CKalitin/analog-bms/README.md

# analog-bms
1s2p Li-ion battery module with an analog battery management system (BMS).

### [**Read The Project Blog Post!!**](https://ckalitin.github.io/analogbms/)



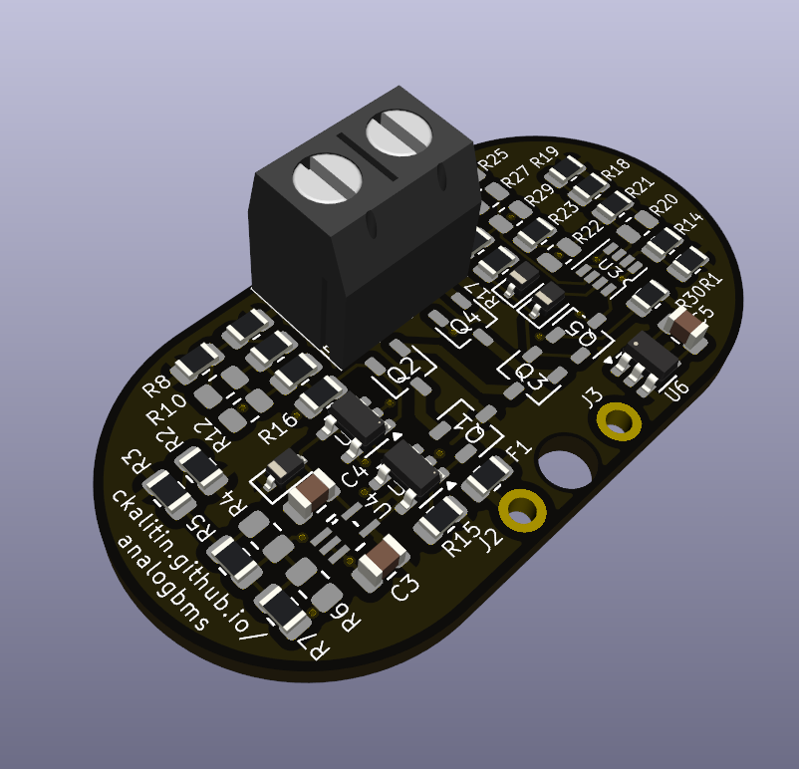
[picture p1: renders/PCB_kicad_3d.png]


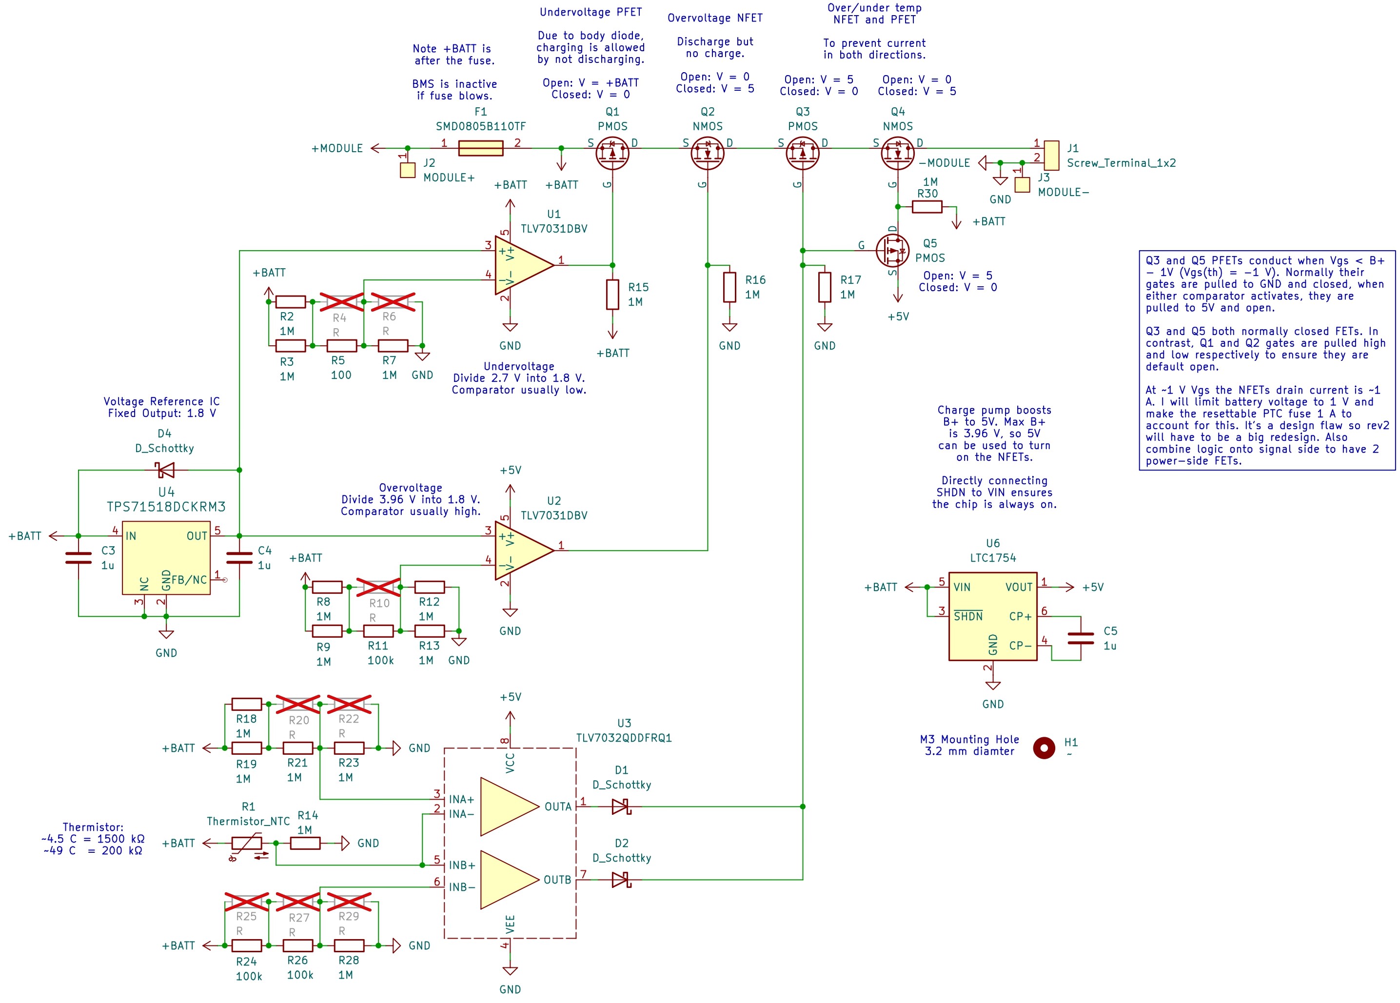
[picture p2: renders/PCB_schematic.jpg]


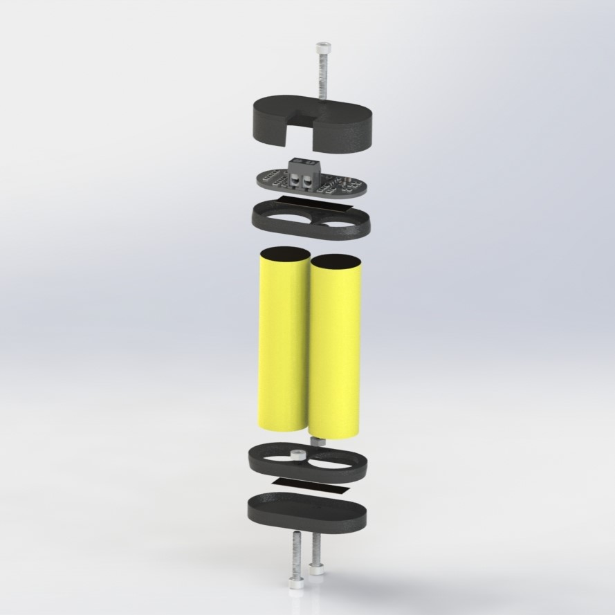
[picture p3: renders/module_exploded.JPG]


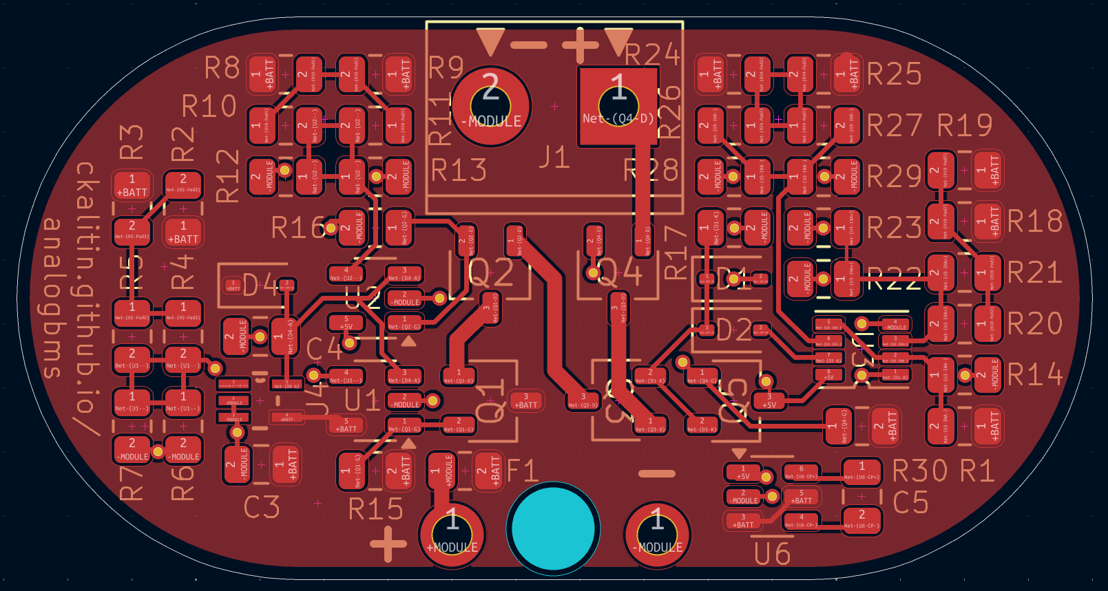
[picture p4: renders/PCB_kicad_top_layer.png]
