CKalitin/analog-bms/pcb/analog_bms_rev1/Images/doro.jpg

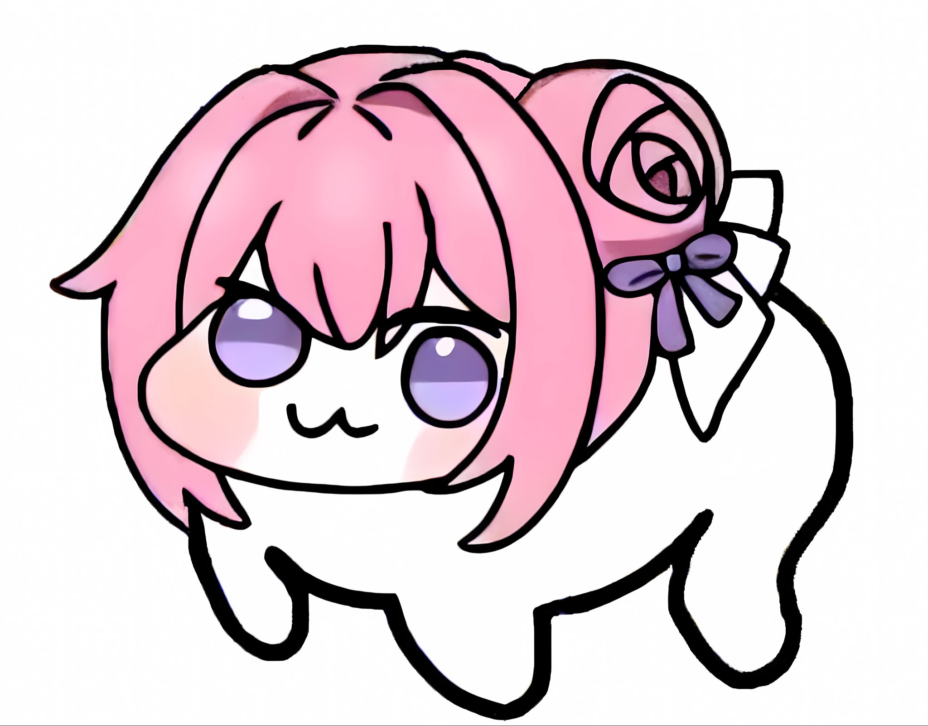
pcb/analog_bms_rev1/Images/doro.jpg
