CKalitin/analog-bms/pcb/analog_bms_rev1/Images/happy-pepe.png

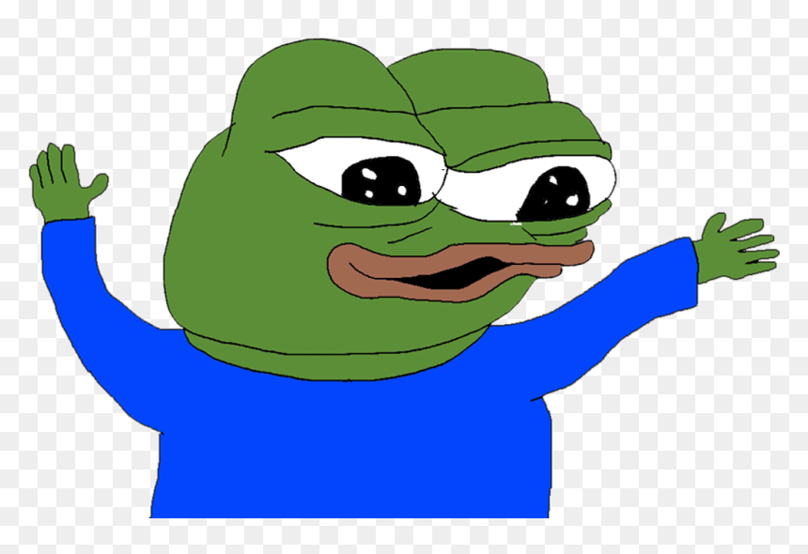
pcb/analog_bms_rev1/Images/happy-pepe.png
