CKalitin/analog-bms/pcb/analog_bms_rev1/Images/pepe-grill.png

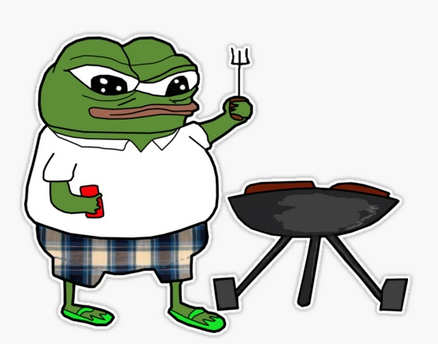
pcb/analog_bms_rev1/Images/pepe-grill.png
