CKalitin/analog-bms/pcb/analog_bms_rev1/Images/pepe-sophisticated.png

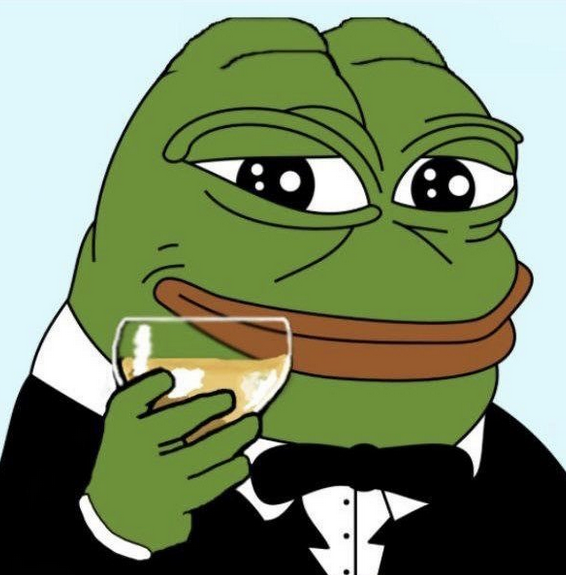
pcb/analog_bms_rev1/Images/pepe-sophisticated.png
