CKalitin/analog-bms/pcb/analog_bms_rev1/Images/pepe-surprised.png

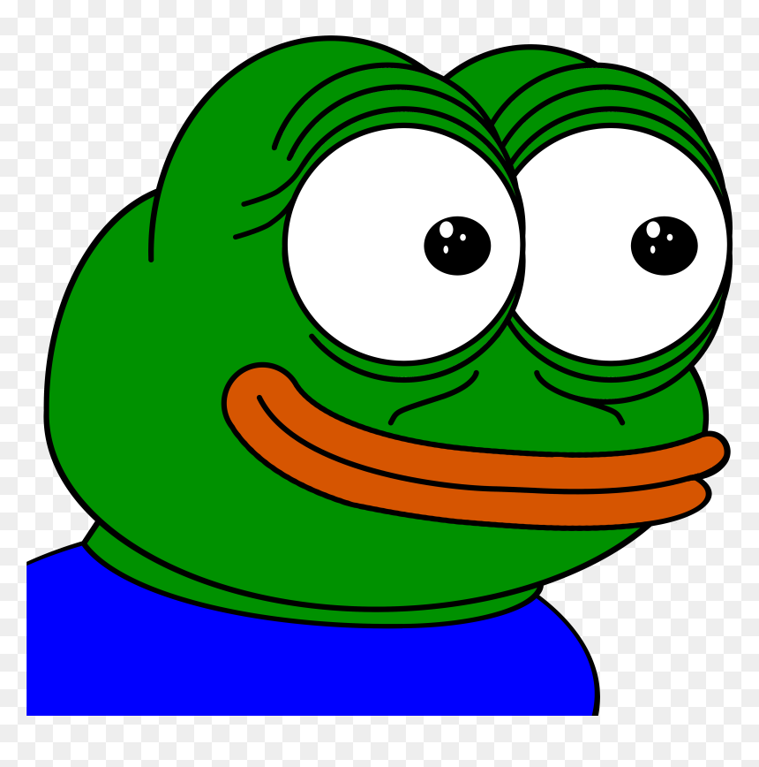
pcb/analog_bms_rev1/Images/pepe-surprised.png
