CKalitin/analog-bms/pcb/analog_bms_rev1/Images/soyface-wow.png

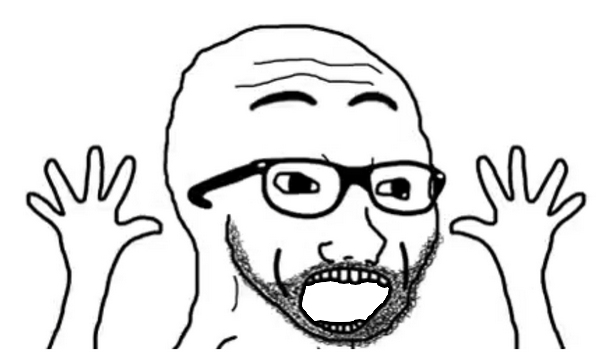
pcb/analog_bms_rev1/Images/soyface-wow.png
