CKalitin/analog-bms/renders/rev1/module.JPG

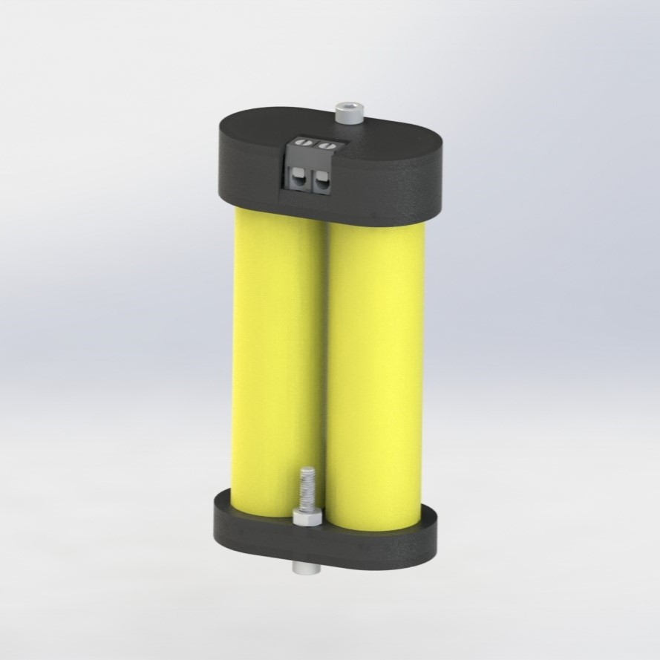
renders/rev1/module.JPG
