CKalitin/analog-bms/renders/rev1/PCB_kicad_top_down.png

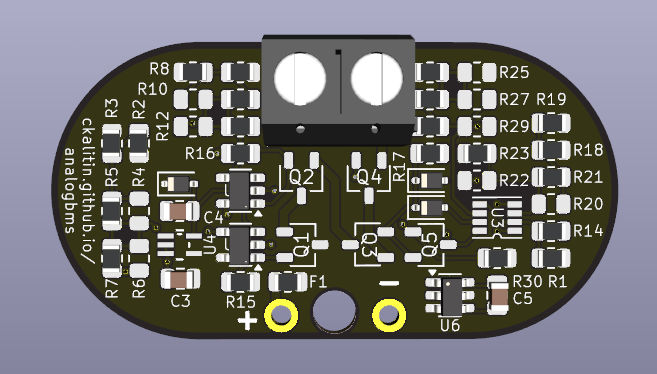
renders/rev1/PCB_kicad_top_down.png
