CKalitin/analog-bms/pcb/analog_bms_rev1/analog_bms.step

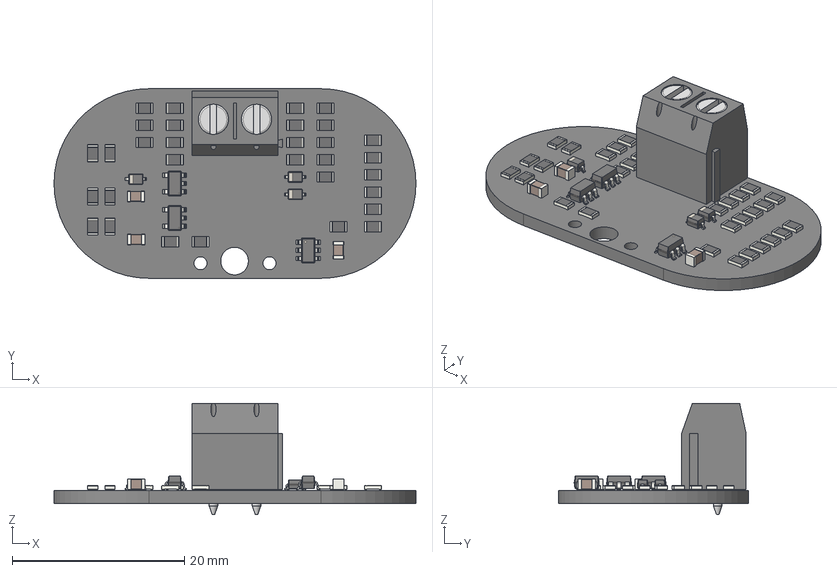
[picture p13: CAD file, 2025-08-20]
pcb/analog_bms_rev1/analog_bms.step
42.0 x 22.0 x 12.9 mm
R_0805_2012Metric x 31
D_SOD-323 x 3
SOT-23-5 x 2
C_0805_2012Metric x 3
SOT-23-6
6915027100xx_CAGE x 2
6915027100xx_PIN x 2
6915027100xx_VIS x 2
analog_bms_PCB
