CKalitin/analog-bms/cad/rev1/Top_Battery_Holder_Plate.SLDPRT

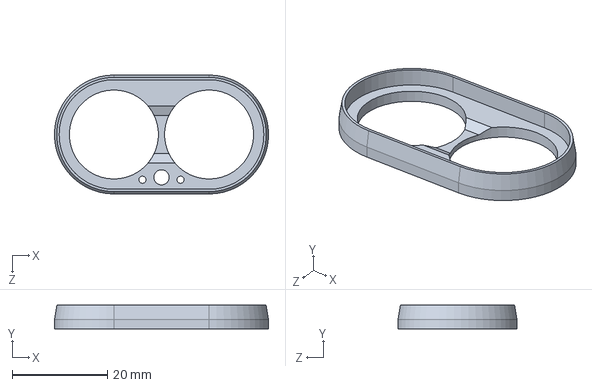
[picture p14: CAD file, 2025-08-20]
cad/rev1/Top_Battery_Holder_Plate.SLDPRT
45.0 x 5.00 x 25.0 mm
