CKalitin/analog-bms/cad/rev1/Top_Module_Exterior_Plate.SLDPRT

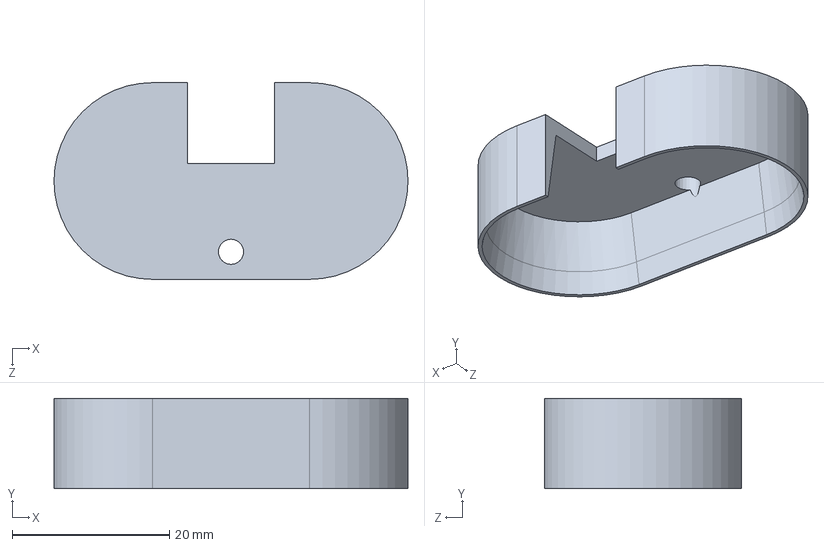
[picture p15: CAD file, 2025-08-20]
cad/rev1/Top_Module_Exterior_Plate.SLDPRT
45.0 x 11.5 x 25.0 mm
