CKalitin/analog-bms/cad/rev1/Bottom_Module_Exterior_Plate.SLDPRT

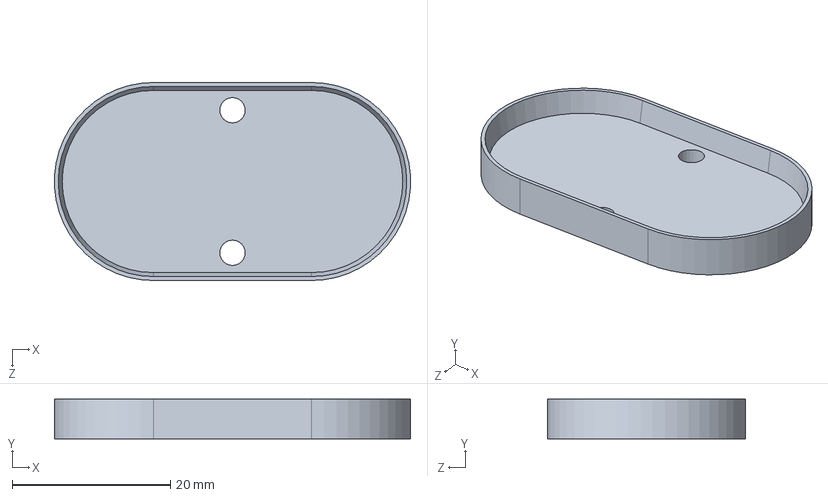
[picture p16: CAD file, 2025-08-20]
cad/rev1/Bottom_Module_Exterior_Plate.SLDPRT
45.0 x 5.00 x 25.0 mm
