CKalitin/analog-bms/cad/rev1/PCB-Printable.SLDPRT

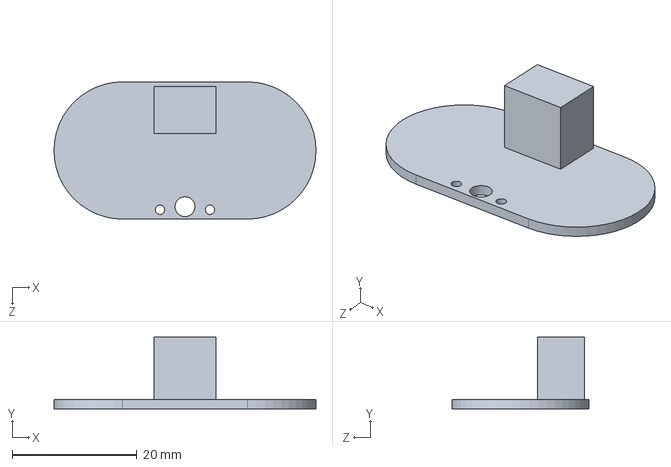
[picture p17: CAD file, 2025-08-20]
cad/rev1/PCB-Printable.SLDPRT
42.0 x 11.5 x 22.0 mm
