CKalitin/analog-bms/pcb/analog_bms_rev1/3D Models/691502710002.stp

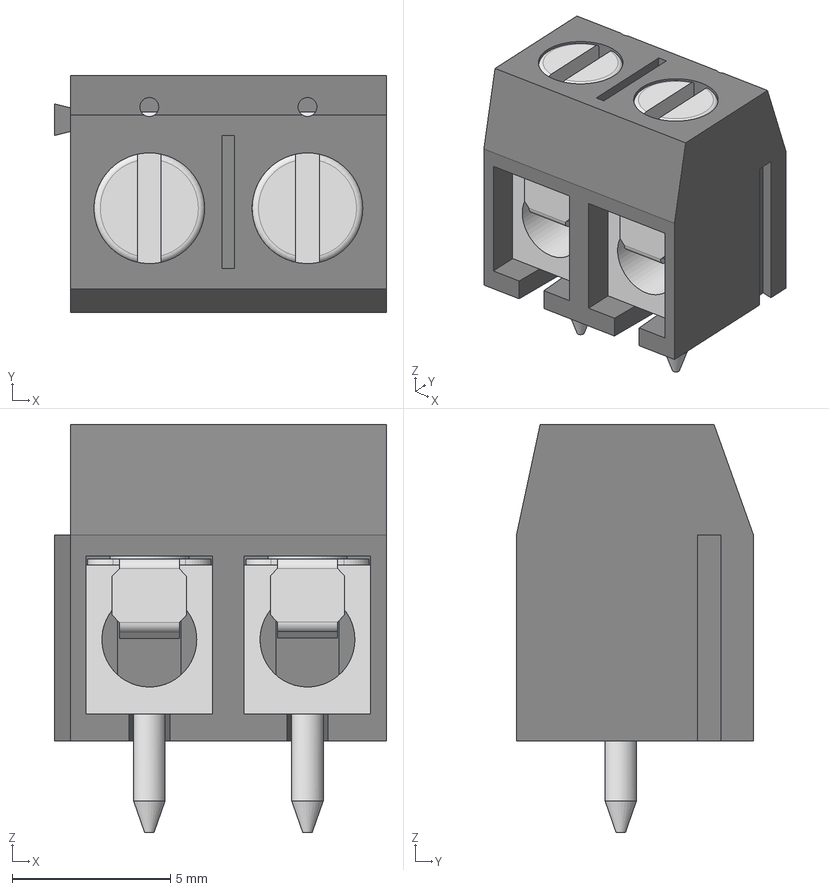
[picture p18: CAD file, 2025-08-19]
pcb/analog_bms_rev1/3D Models/691502710002.stp
10.5 x 7.50 x 12.9 mm
6915027100xx_CAGE x 2
6915027100xx_PIN x 2
6915027100xx_VIS x 2
