CKalitin/analog-bms/cad/rev1/18650_Nickel_Tab.SLDPRT

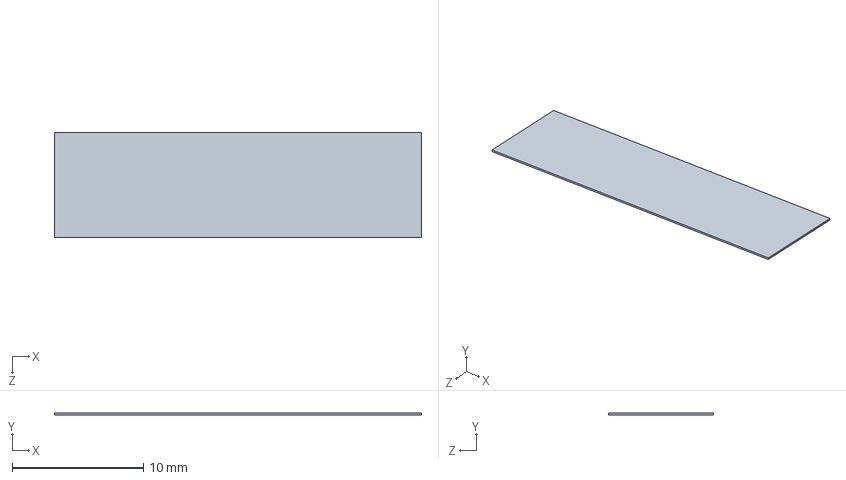
[picture p19: CAD file, 2025-08-20]
cad/rev1/18650_Nickel_Tab.SLDPRT
28.0 x 0.15 x 8.00 mm
