CKalitin/analog-bms/cad/rev1/18650.SLDPRT

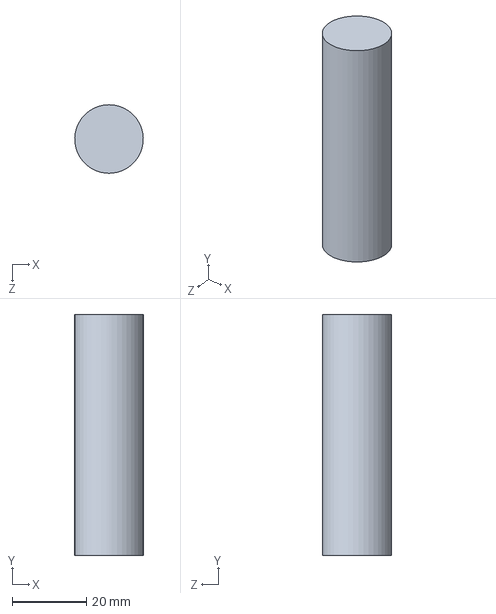
[picture p20: CAD file, 2025-08-20]
cad/rev1/18650.SLDPRT
18.5 x 65.0 x 18.5 mm
