CKalitin/analog-bms/cad/rev1/91290A121_Alloy Steel Socket Head Screw.SLDPRT

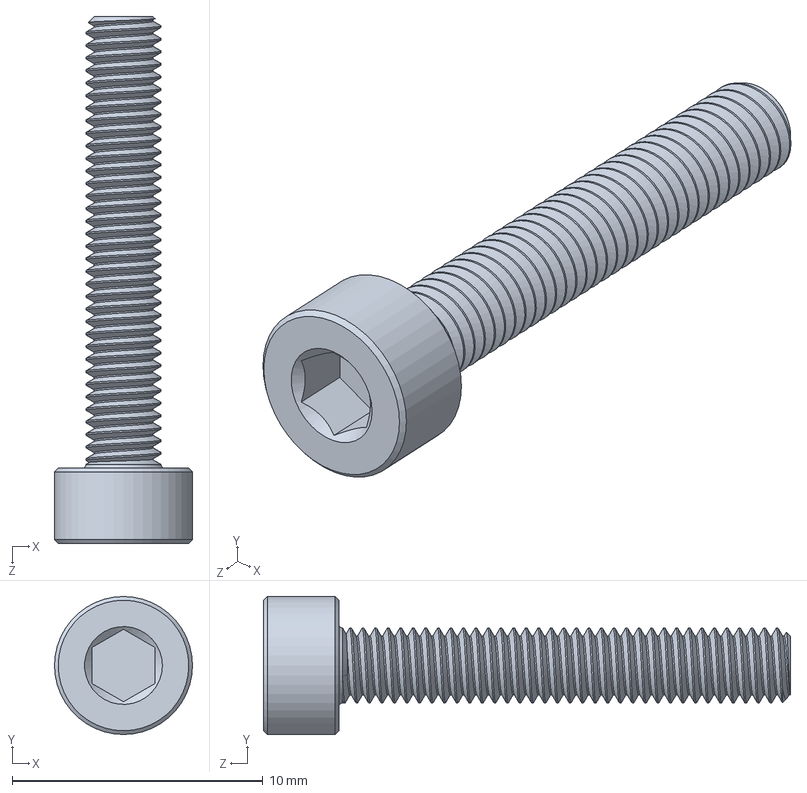
[picture p21: CAD file, 2025-08-19]
cad/rev1/91290A121_Alloy Steel Socket Head Screw.SLDPRT
5.50 x 5.50 x 21.0 mm
