CKalitin/analog-bms/cad/rev1/90593A001_Black-Oxide Steel Hex Nut.SLDPRT

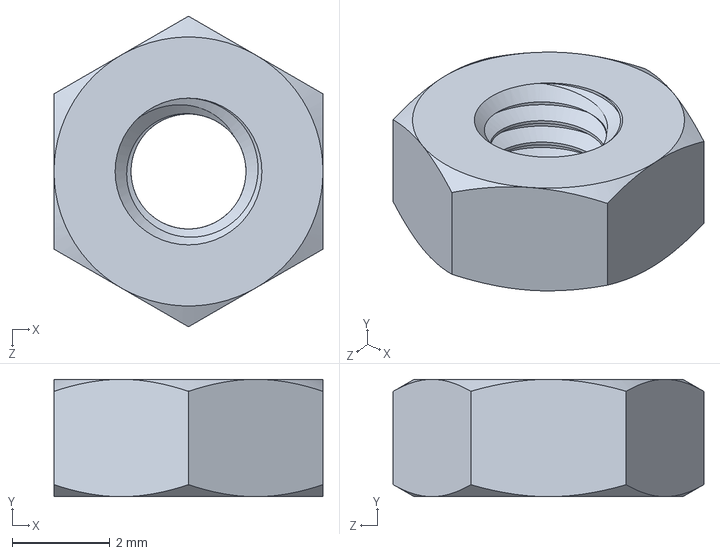
[picture p22: CAD file, 2025-08-19]
cad/rev1/90593A001_Black-Oxide Steel Hex Nut.SLDPRT
5.50 x 2.40 x 6.35 mm
