CKalitin/analog-bms/cad/rev1/18650_Tab_Printable.SLDPRT

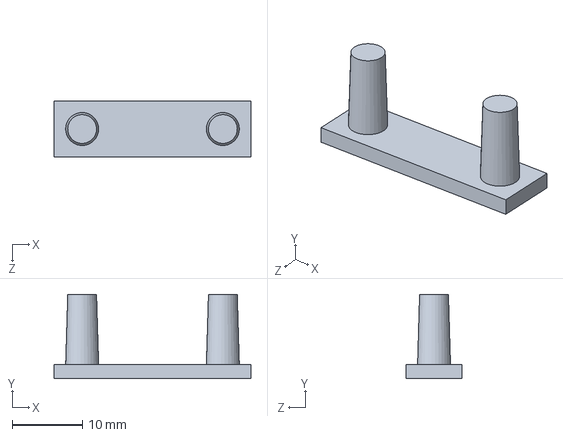
[picture p23: CAD file, 2025-08-19]
cad/rev1/18650_Tab_Printable.SLDPRT
28.0 x 12.0 x 8.00 mm
