CKalitin/analog-bms/cad/rev1/18650_Printable.SLDPRT

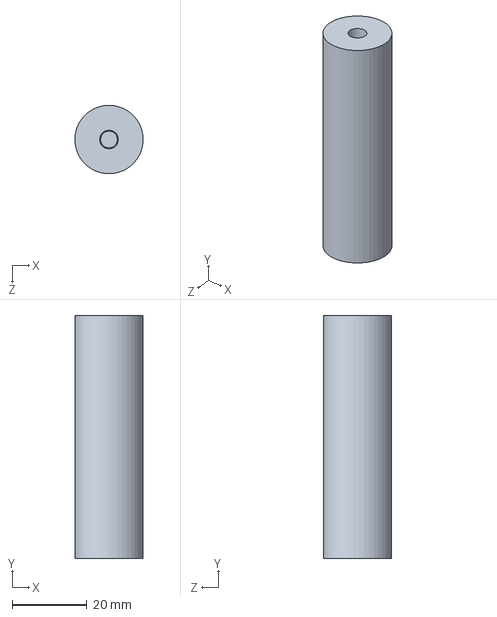
[picture p24: CAD file, 2025-08-19]
cad/rev1/18650_Printable.SLDPRT
18.3 x 65.0 x 18.3 mm
