CKalitin/analog-bms/cad/rev1/Module.SLDASM

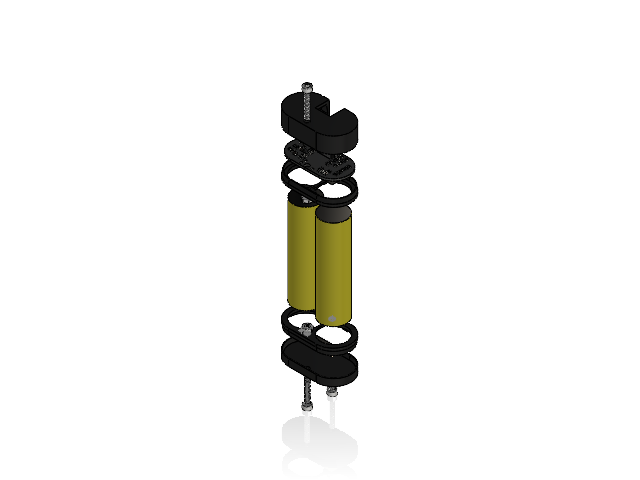
[picture p25: CAD file, 2025-12-03]
cad/rev1/Module.SLDASM
Bottom_Battery_Holder_Plate
18650_Nickel_Tab x 2
Top_Battery_Holder_Plate
Bottom_Module_Exterior_Plate
691502710002-0.step
6915027100xx_CAGE.step x 2
6915027100xx_PIN.step x 2
6915027100xx_VIS.step x 2
R_0805_2012Metric.step x 31
D_SOD-323.step x 3
SOT-23-5.step x 2
C_0805_2012Metric.step x 3
SOT-23-6.step
analog_bms_PCB.step
Top_Module_Exterior_Plate
91290A121_Alloy Steel Socket Head Screw x 3
90593A001_Black-Oxide Steel Hex Nut x 3
