CKalitin/analog-bms/cad/rev1/PCB.SLDASM

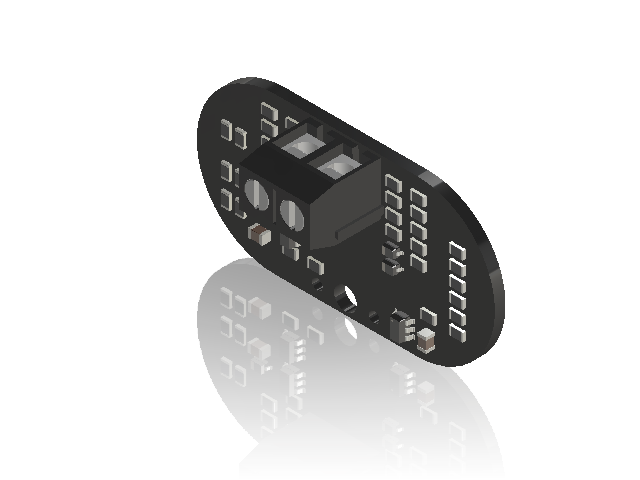
[picture p26: CAD file, 2025-08-20]
cad/rev1/PCB.SLDASM
691502710002-0.step
6915027100xx_CAGE.step x 2
6915027100xx_PIN.step x 2
6915027100xx_VIS.step x 2
R_0805_2012Metric.step x 31
D_SOD-323.step x 3
SOT-23-5.step x 2
C_0805_2012Metric.step x 3
SOT-23-6.step
analog_bms_PCB.step
