CKalitin/analog-bms/(list of files, cad)

Other CAD files:
cad/rev1/Bottom_Battery_Holder_Plate.SLDPRT
cad/rev1/print_files/18650_Printable.STL
cad/rev1/print_files/18650_Tab_Printable.STL
cad/rev1/print_files/Bottom_Battery_Holder_Plate.STL
cad/rev1/print_files/Bottom_Module_Exterior_Plate.STL
cad/rev1/print_files/PCB.STL
cad/rev1/print_files/PCB_Printable.STL
cad/rev1/print_files/Top_Battery_Holder_Plate.STL
cad/rev1/print_files/Top_Module_Exterior_Plate.STL
