CKalitin/analog-bms/tests/rev_1/PCB_Voltage-Labels_5_Thermistor-Comparator_No-200-ohm_Resoldered.pdf

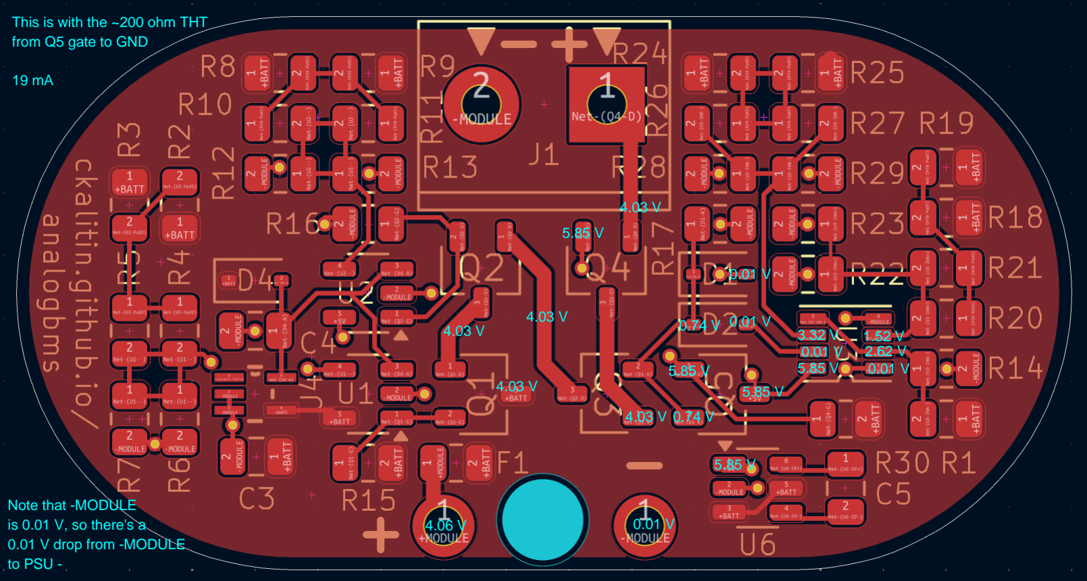
[picture p27: page 1]
