CKalitin/analog-bms/tests/rev_1/PCB_Voltage-Labels_3_2V6_Resistors.pdf

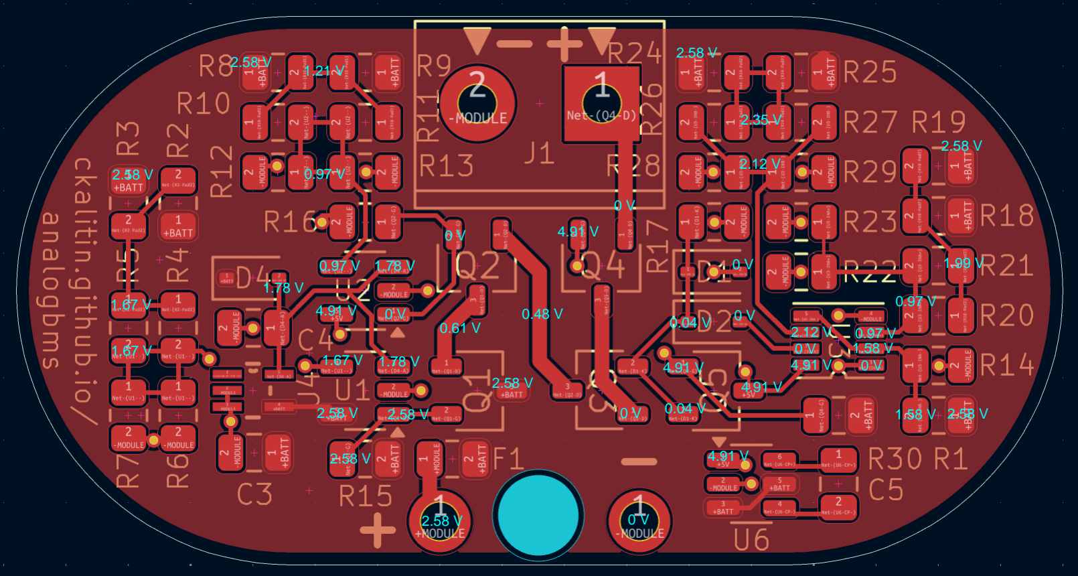
[picture p28: page 1]
