CKalitin/analog-bms/tests/rev_1/PCB_Voltage-Labels_3_3V5_Resistors.pdf

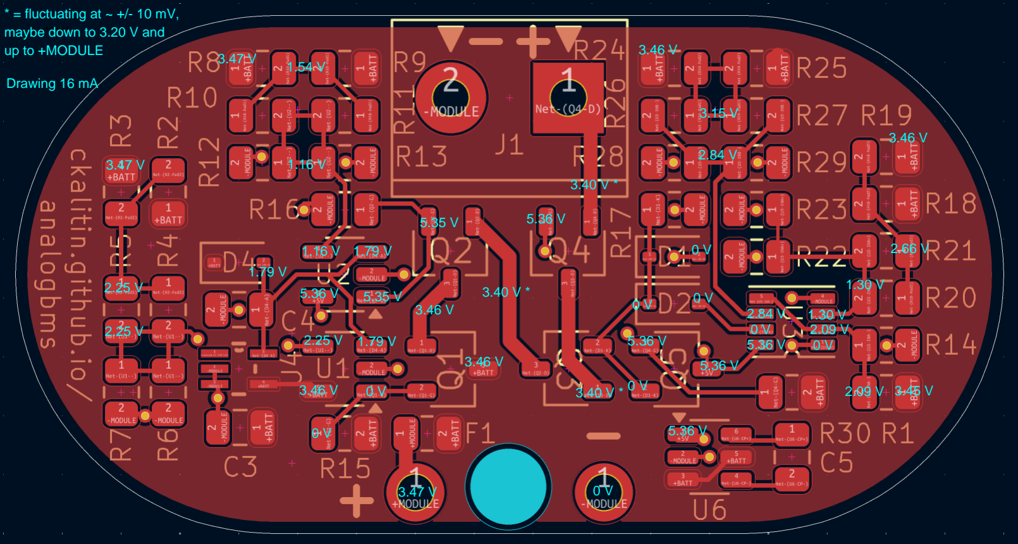
[picture p29: page 1]
