CKalitin/analog-bms/tests/rev_1/PCB_Voltage-Labels_3_4V1_Resistors.pdf

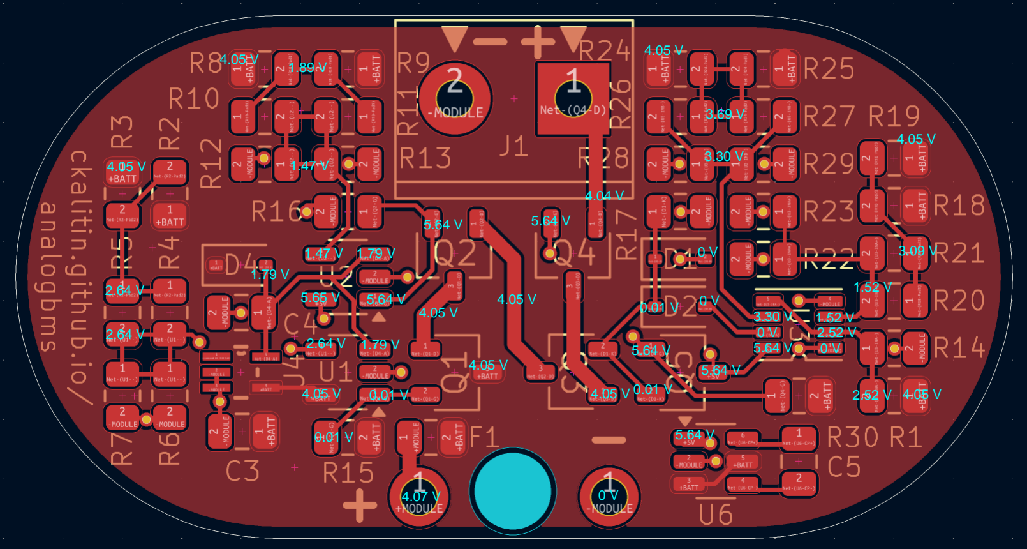
[picture p30: page 1]
