CKalitin/analog-bms/tests/rev_1/PCB_Voltage-Labels_4_Thermistor-Comparator_No-200-ohm.pdf

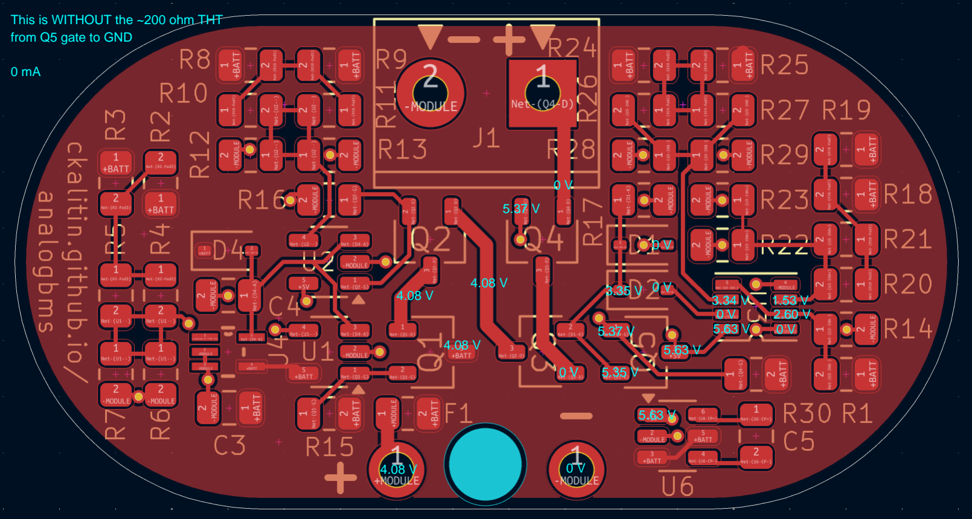
[picture p31: page 1]
