CKalitin/analog-bms/tests/rev_1/PCB_Voltage-Labels_4_Thermistor-Comparator_With-200-ohm.pdf

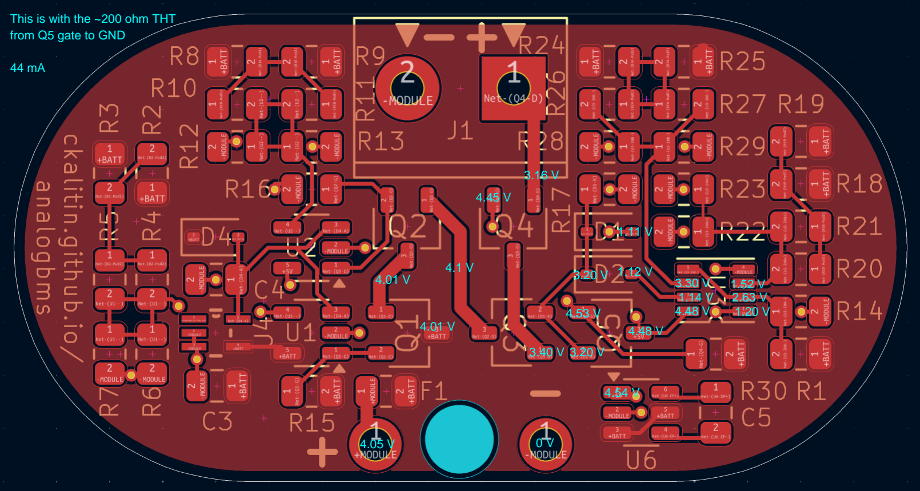
[picture p32: page 1]
