CKalitin/analog-bms/tests/rev_1/PCB_Voltage-Labels_2_Rotated-FETs.pdf

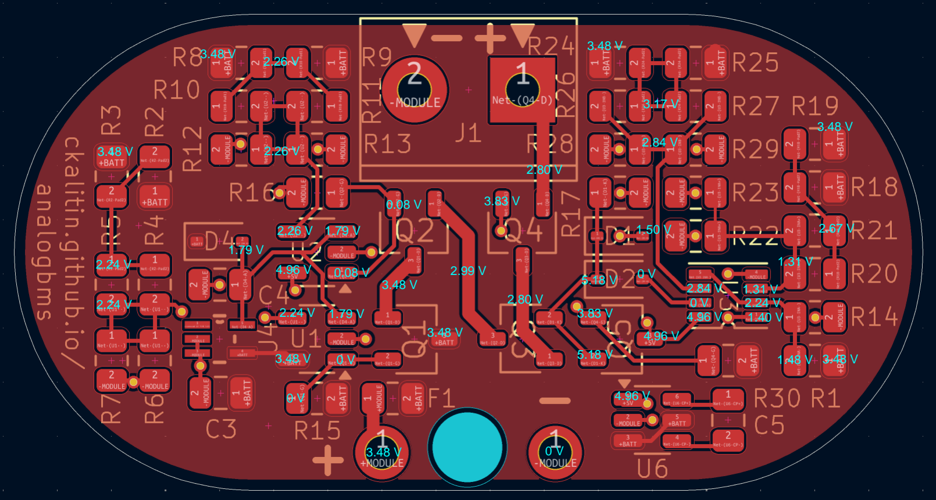
[picture p33: page 1]
