CKalitin/analog-bms/tests/rev_1/PCB_Voltage-Labels_2_Rotated-FETs_PT2.pdf

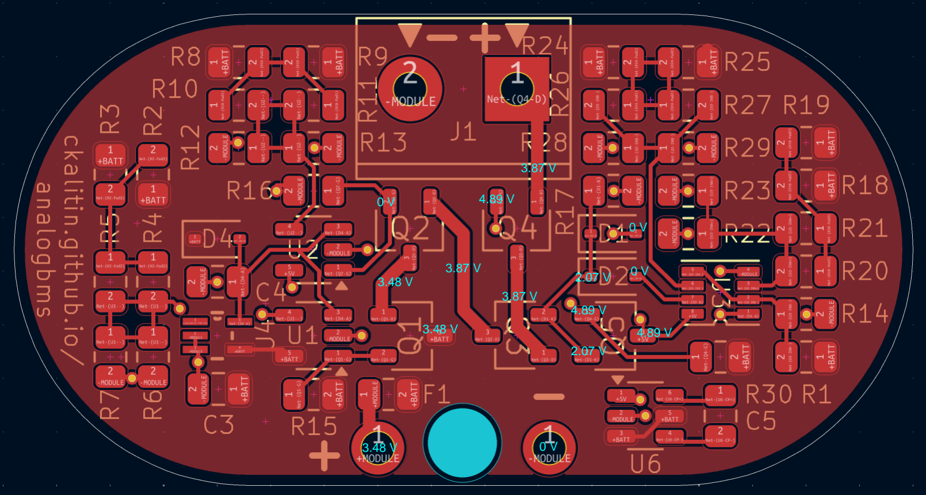
[picture p34: page 1]
