CKalitin/analog-bms/tests/rev_1/PCB_Voltage-Labels_2_Rotated-FETs_PT3.pdf

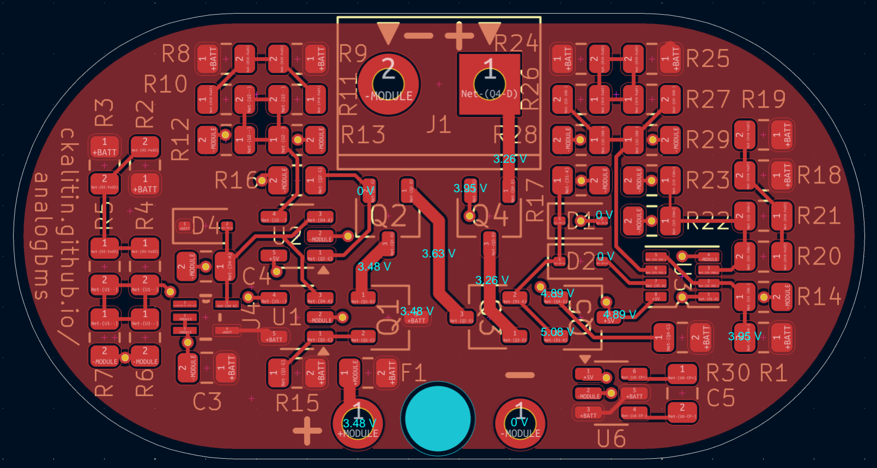
[picture p35: page 1]
