CKalitin/analog-bms/tests/rev_1/PCB_Voltage-Labels_1_Original.pdf

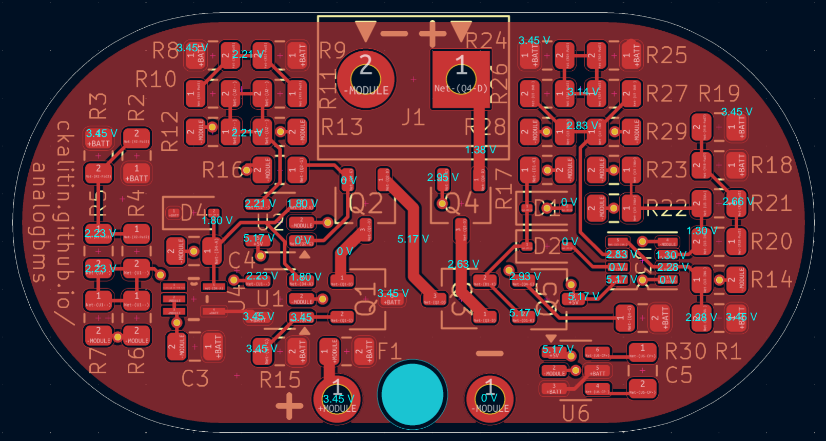
[picture p36: page 1]
