CKalitin/analog-bms/pcb/analog_bms_rev1/schematic.pdf

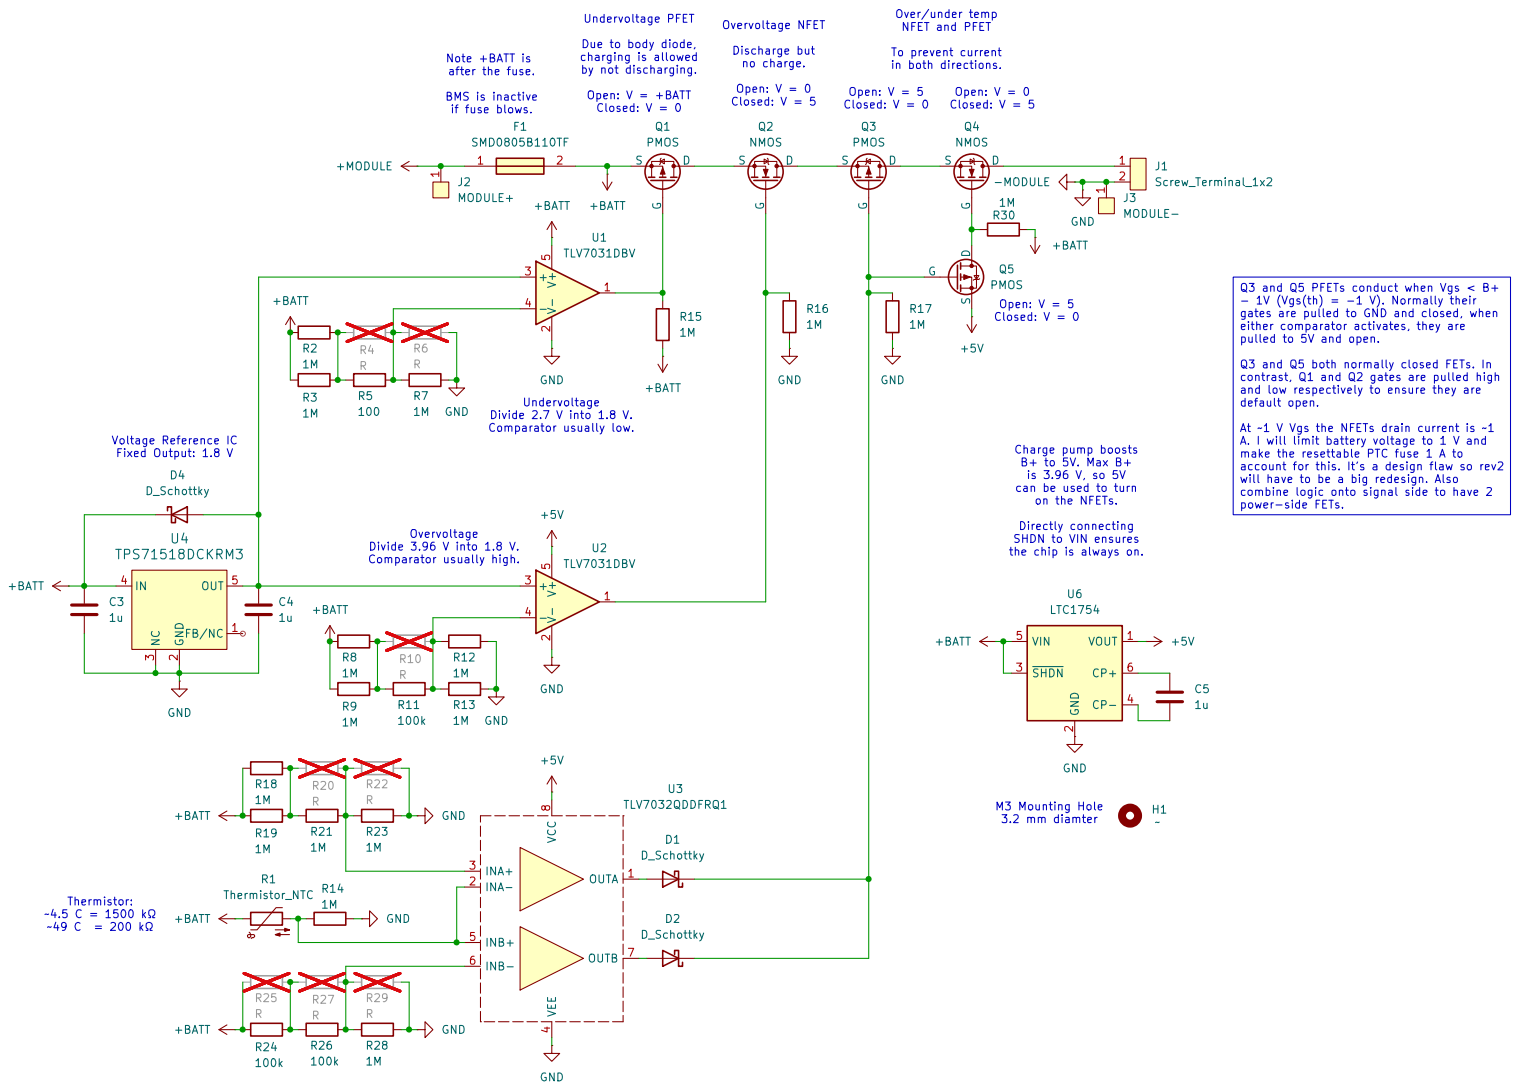
[picture p37: page 1]
