CKalitin/analog-bms/ltspice/rev1/analogbms.asc

D1: diode
D2: diode
M1: pmos
M2: nmos
M3: pmos
M4: nmos
M5: pmos
R1: res; 1Meg
R2: res; 1Meg
R3: res; 1Meg
R4: res; 1Meg
R5: res; 10k
R6: res; 1Meg
R7: res; 100
R8: res; 100
R9: res; 1Meg
R10: res; 1Meg
R12: res; 10k
R14: res; 1k
R15: res; 10k
R16: res; 10k
R18: res; 1Meg
R20: res; 1Meg
R21: res; 1Meg
R22: res; 1Meg
R23: res; 1Meg
R24: res; 1Meg
R26: res; 1Meg
R28: res; 100k
R30: res; 1Meg
U1: LT1720
U2: LT1720
U3: LT1720
U4: LT1720
V1: voltage; 5
V2: voltage; 2.7
V3: voltage; 1.8
Named nets: 0, 5V, Batt+, 1V8, Vtemp
.tran 1
