CKalitin/analog-bms/pcb/analog_bms_rev1/analog_bms.kicad_pcb

## KiCad design pcb/analog_bms_rev1/analog_bms.kicad_pcb (2025-09-29)

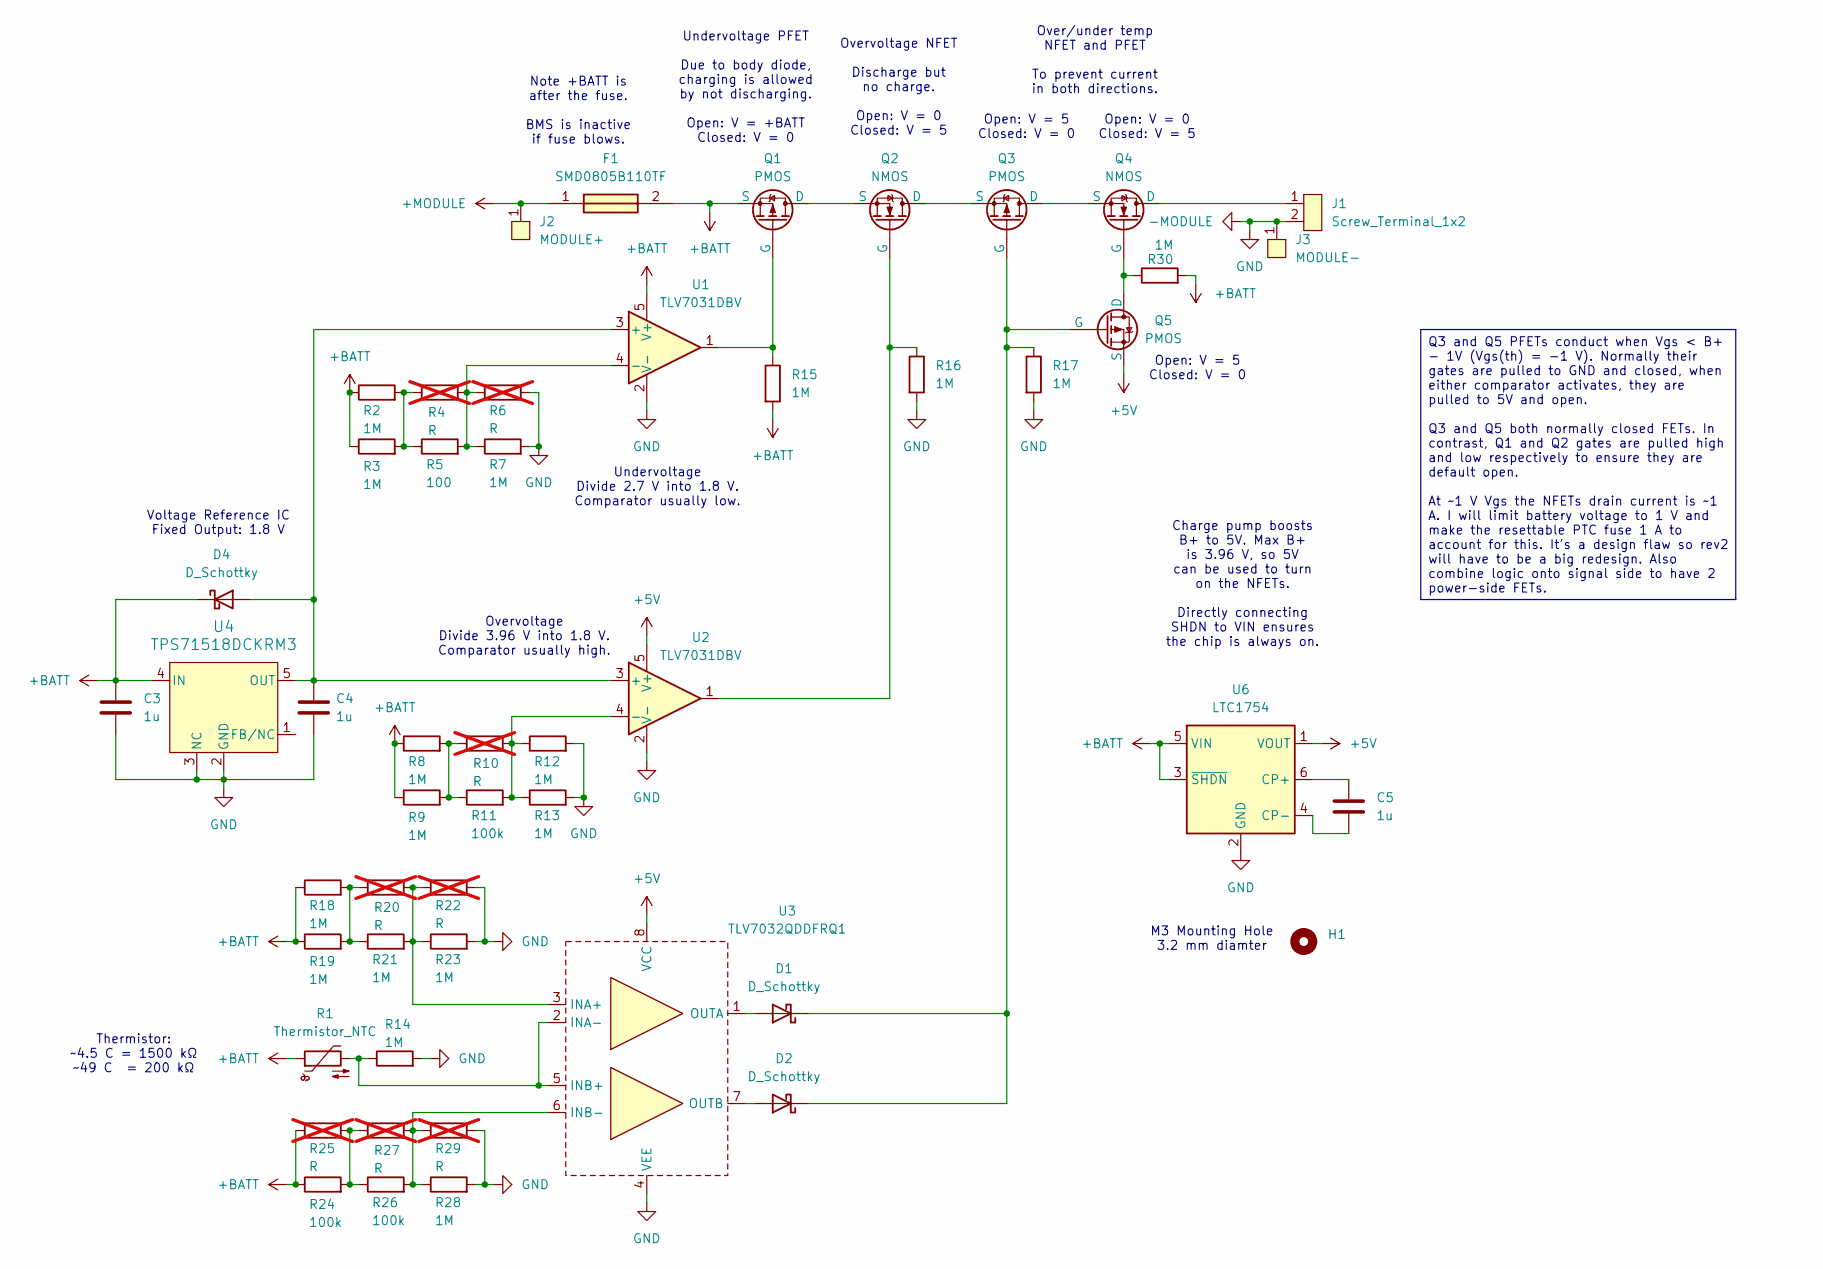
[picture p38: schematic analog_bms.kicad_sch, Analog BMS]

Parts:
C3, C4, C5: 1u; C_0805_2012Metric
D1, D2, D4: D_Schottky; D_SOD-323
F1: SMD0805B110TF; R_0805_2012Metric; Mouser Part Number 603-SMD0805B110TF
H1: M3_Mounting_Through_Hole
J1: Screw_Terminal_1x2; 691502710002
J2: MODULE+; 1.5_mm_Through_Hole
J3: MODULE-; 1.5_mm_Through_Hole
Q1, Q3, Q5: PMOS; TSOT_23_No_Arrow
Q2, Q4: NMOS; TSOT_23_No_Arrow
R1: Thermistor_NTC; R_0805_2012Metric
R2, R3, R7, R8, R9, R12, R13, R14, R15, R16, R17, R18, R19, R21, R23, R28, R30: 1M; R_0805_2012Metric
R4, R6, R10, R20, R22, R25, R27, R29: R; R_0805_2012Metric; not fitted
R5: 100; R_0805_2012Metric
R11, R24, R26: 100k; R_0805_2012Metric
U1, U2: TLV7031DBV; SOT-23-5
U3: TLV7032QDDFRQ1
U4: TPS71518DCKRM3
U6: LTC1754; SOT-23-6

Connections:
+5V: Q5.3 (S), U2.5 (V+), U3.8 (VCC), U6.1 (VOUT)
+BATT: C3.1, D4.1 (K), F1.2, Q1.3 (S), R1.1, R2.1, R3.1, R8.1, R9.1, R15.2, R18.1, R19.1, R24.1, R25.1, R30.2, U1.5 (V+), U4.4 (IN), U6.3 (~SHDN), U6.5 (VIN)
+MODULE: F1.1, J2.1
-MODULE: C3.2, C4.2, J1.2, J3.1, R6.2, R7.2, R12.2, R13.2, R14.2, R16.2, R17.2, R22.2, R23.2, R28.2, R29.2, U1.2 (V-), U2.2 (V-), U3.4 (VEE), U4.2 (GND), U4.3 (NC), U6.2 (GND)
unnamed: D1.2 (A), U3.1 (OUTA)
unnamed: D1.1 (K), D2.1 (K), Q3.2 (G), Q5.2 (G), R17.1
unnamed: D2.2 (A), U3.7 (OUTB)
unnamed: C4.1, D4.2 (A), U1.3 (+), U2.3 (+), U4.5 (OUT)
unnamed: Q1.1 (D), Q2.3 (S)
unnamed: Q1.2 (G), R15.1, U1.1
unnamed: Q2.1 (D), Q3.3 (S)
unnamed: Q2.2 (G), R16.1, U2.1
unnamed: Q3.1 (D), Q4.3 (S)
unnamed: J1.1, Q4.1 (D)
unnamed: Q4.2 (G), Q5.1 (D), R30.1
unnamed: R2.2, R3.2, R4.1, R5.1
unnamed: R8.2, R9.2, R10.1, R11.1
unnamed: R18.2, R19.2, R20.1, R21.1
unnamed: R24.2, R25.2, R26.1, R27.1
unnamed: R4.2, R5.2, R6.1, R7.1, U1.4 (-)
unnamed: R10.2, R11.2, R12.1, R13.1, U2.4 (-)
unnamed: R20.2, R21.2, R22.1, R23.1, U3.3 (INA+)
unnamed: R1.2, R14.1, U3.2 (INA-), U3.5 (INB+)
unnamed: R26.2, R27.2, R28.1, R29.1, U3.6 (INB-)
unnamed: C5.1, U6.6 (CP+)
unnamed: C5.2, U6.4 (CP-)

Notes on the sheet:
Voltage Reference IC Fixed Output: 1.8 V
Note +BATT is after the fuse. BMS is inactive if fuse blows.
Open: V = 5 Closed: V = 0
Over/under temp NFET and PFET To prevent current in both directions.
M3 Mounting Hole 3.2 mm diamter
Overvoltage NFET Discharge but no charge. Open: V = 0 Closed: V = 5
Charge pump boosts B+ to 5V. Max B+ is 3.96 V, so 5V can be used to turn on the NFETs. Directly connecting SHDN to VIN ensures the chip is always on.
Undervoltage PFET Due to body diode, charging is allowed by not discharging. Open: V = +BATT Closed: V = 0
Undervoltage Divide 2.7 V into 1.8 V. Comparator usually low.
Overvoltage Divide 3.96 V into 1.8 V. Comparator usually high.
Thermistor: ~4.5 C = 1500 kΩ ~49 C = 200 kΩ
Open: V = 0 Closed: V = 5
Open: V = 5 Closed: V = 0
Q3 and Q5 PFETs conduct when Vgs < B+ - 1V (Vgs(th) = -1 V). Normally their gates are pulled to GND and closed, when either comparator activates, they are pulled to 5V and open. Q3 and Q5 both normally closed FETs. In contrast, Q1 and Q2 gates are pulled high and low respectively to ensure they are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

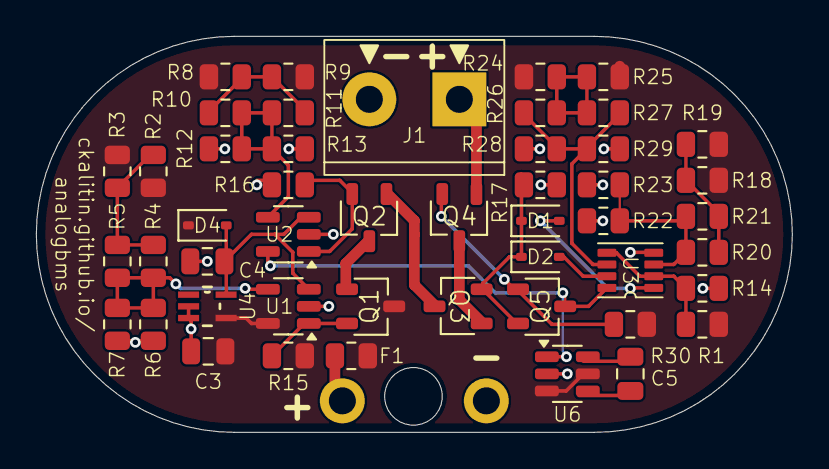
[picture p39: board analog_bms.kicad_pcb from above]

Board: 2 copper layers, 42.0 x 22.0 mm, 51 parts (0 on the bottom side), 26 nets.
