CKalitin/analog-bms/(commit log)

2025-08-19 Schematic rev1
    [analog_bms.kicad_pcb, analog_bms.kicad_sch]
2025-08-19 Printable 18650 + Mounting Hole
    [18650_Printable.SLDPRT, 18650_Printable.STL, 18650_Tab_Printable.SLDPRT, 18650_Tab_Printable.STL, 691502710002.stp, Module_End.SLDPRT, PCB.step, analog_bms.kicad_pcb]
2025-08-19 CAD Model
    [18650.SLDPRT, 18650_Nickel_Tab.SLDPRT, 18650_Printable.STL, 18650_Tab_Printable.SLDPRT, 18650_Tab_Printable.STL, 90593A001_Black-Oxide Steel Hex Nut.SLDPRT, 91290A121_Alloy Steel Socket Head Screw.SLDPRT, Bottom_Battery_Holder_Plate.SLDPRT]
2025-08-20 PCB Design Complete - Pass DRC
    Still skeptical of the DRC. Some very close silk screen elements.
    [Bottom_Battery_Holder_Plate.SLDPRT, Bottom_Battery_Holder_Plate.STL, Bottom_Module_Exterior_Plate.STL, Module.SLDASM, PCB-Printable.SLDPRT, PCB.SLDASM, PCB.STL, PCB.step]
2025-08-20 Black PCB + Renders
    [18650.SLDPRT, 18650_Nickel_Tab.SLDPRT, Bottom_Battery_Holder_Plate.SLDPRT, Bottom_Module_Exterior_Plate.SLDPRT, PCB.SLDASM, PCB.step, Top_Battery_Holder_Plate.SLDPRT, Top_Module_Exterior_Plate.SLDPRT]
2025-08-20 pepes heh
    [analog_bms.kicad_pcb]
2025-08-20 + & - silkscreen
    [analog_bms.kicad_pcb]
2025-08-20 Updated rules & solid connection pours
    [analog_bms.kicad_pcb]
2025-08-24 Fix comparator + pour to track dist
    [analog_bms.kicad_pcb]
2025-08-24 Digikey, TI, and PCBWay orders!
    [analog_bms-B_Mask.gbr, analog_bms-B_Paste.gbr, analog_bms-B_SilkS.gbr, analog_bms-Back.gbr, analog_bms-Edge_Cuts.gbr, analog_bms-F_Mask.gbr, analog_bms-F_Paste.gbr, analog_bms-F_SilkS.gbr]
2025-09-21 LTspice sim + attempt at fixing OV UV dividers
    [analog_bms.kicad_sch]
2025-09-21 All FET footprints are wrong
2025-09-22 Fixed OV divider & Q3/5 pulldown stronger
    [analog_bms.kicad_pcb, analog_bms.kicad_sch]
2025-09-29 More PCB trace voltage testing
    [analog_bms.kicad_pcb]
2025-10-05 Update schematic jpg
2025-12-03 Reorganize for rev2
    Man I thought this was gonna be a 3 day speedrun and I'd be done with it
    [18650.SLDPRT, 18650_Nickel_Tab.SLDPRT, 18650_Printable.SLDPRT, 18650_Printable.STL, 18650_Tab_Printable.SLDPRT, 18650_Tab_Printable.STL, 691502710002.stp, 90593A001_Black-Oxide Steel Hex Nut.SLDPRT]
